joslumar/JosluFocuser/Board/Focuser-proto.brd

## EAGLE design Board/Focuser-proto.brd (2017-05-20)

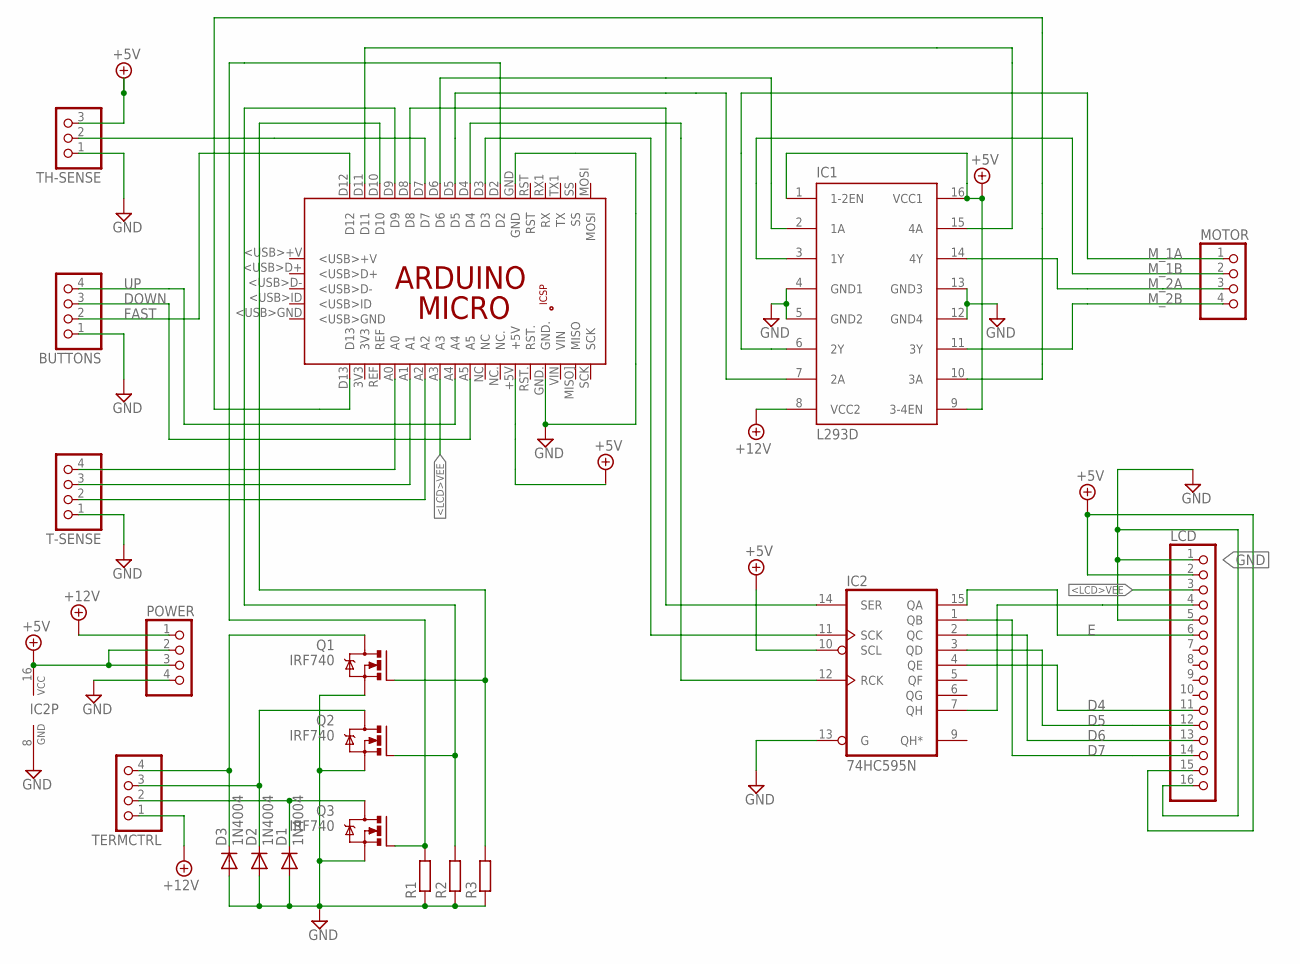
[picture p1: schematic Focuser-proto.sch]

Parts:
BUTTONS: PINHD-1X4; 1X04
D1, D2, D3: 1N4004; DO41-10
IC1: L293D; DIL16
IC2: 74HC595N; DIL16
LCD: PINHD-1X16; 1X16
MOTOR: PINHD-1X4; 1X04
PCB1: ARDUINO_MICRO
POWER: PINHD-1X4; 1X04
Q1, Q2, Q3: IRF740; TO220BV
R1, R2, R3: R-EU_0207/7; 0207/7
T-SENSE: PINHD-1X4; 1X04
TERMCTRL: PINHD-1X4; 1X04
TH-SENSE: PINHD-1X3; 1X03

Connections:
+5V: IC1.1 (1-2EN), IC1.9 (3-4EN), IC1.16 (VCC1), IC2.10 (SCL), IC2.16 (VCC), LCD.2, LCD.15, PCB1.+5V, POWER.2, POWER.3, TH-SENSE.3
+12V: IC1.8 (VCC2), POWER.1, TERMCTRL.1
<LCD>VEE: LCD.3, PCB1.A3
D4: IC2.4 (QE), LCD.11
D5: IC2.3 (QD), LCD.12
D6: IC2.2 (QC), LCD.13
D7: IC2.1 (QB), LCD.14
DOWN: BUTTONS.3, PCB1.A5
E: IC2.15 (QA), LCD.6
FAST: BUTTONS.2, PCB1.D12
GND: BUTTONS.1, D1.A, D2.A, D3.A, IC1.4 (GND1), IC1.5 (GND2), IC1.12 (GND4), IC1.13 (GND3), IC2.8 (GND), IC2.13 (G), LCD.1, LCD.5, LCD.16, PCB1.GND, PCB1.GND., POWER.4, Q1.S, Q2.S, Q3.S, R1.1, R2.1, R3.1, T-SENSE.1, TH-SENSE.1
M_1A: IC1.6 (2Y), MOTOR.1
M_1B: IC1.3 (1Y), MOTOR.2
M_2A: IC1.14 (4Y), MOTOR.3
M_2B: IC1.11 (3Y), MOTOR.4
unnamed: PCB1.A2, T-SENSE.2
unnamed: PCB1.A0, T-SENSE.4
unnamed: PCB1.A1, T-SENSE.3
unnamed: D1.C, Q3.D, TERMCTRL.2
unnamed: D2.C, Q2.D, TERMCTRL.3
unnamed: D3.C, Q1.D, TERMCTRL.4
unnamed: PCB1.D2, Q3.G, R1.2
unnamed: IC2.11 (SCK), PCB1.D3
unnamed: IC1.2 (1A), PCB1.D6
unnamed: IC1.7 (2A), PCB1.D5
unnamed: IC1.15 (4A), PCB1.D11
unnamed: IC1.10 (3A), PCB1.D13
unnamed: PCB1.D7, TH-SENSE.2
unnamed: IC2.12 (RCK), PCB1.D4
unnamed: IC2.14 (SER), PCB1.D8
unnamed: IC2.7 (QH), LCD.4
unnamed: PCB1.D9, Q2.G, R2.2
unnamed: PCB1.D10, Q1.G, R3.2
UP: BUTTONS.4, PCB1.A4

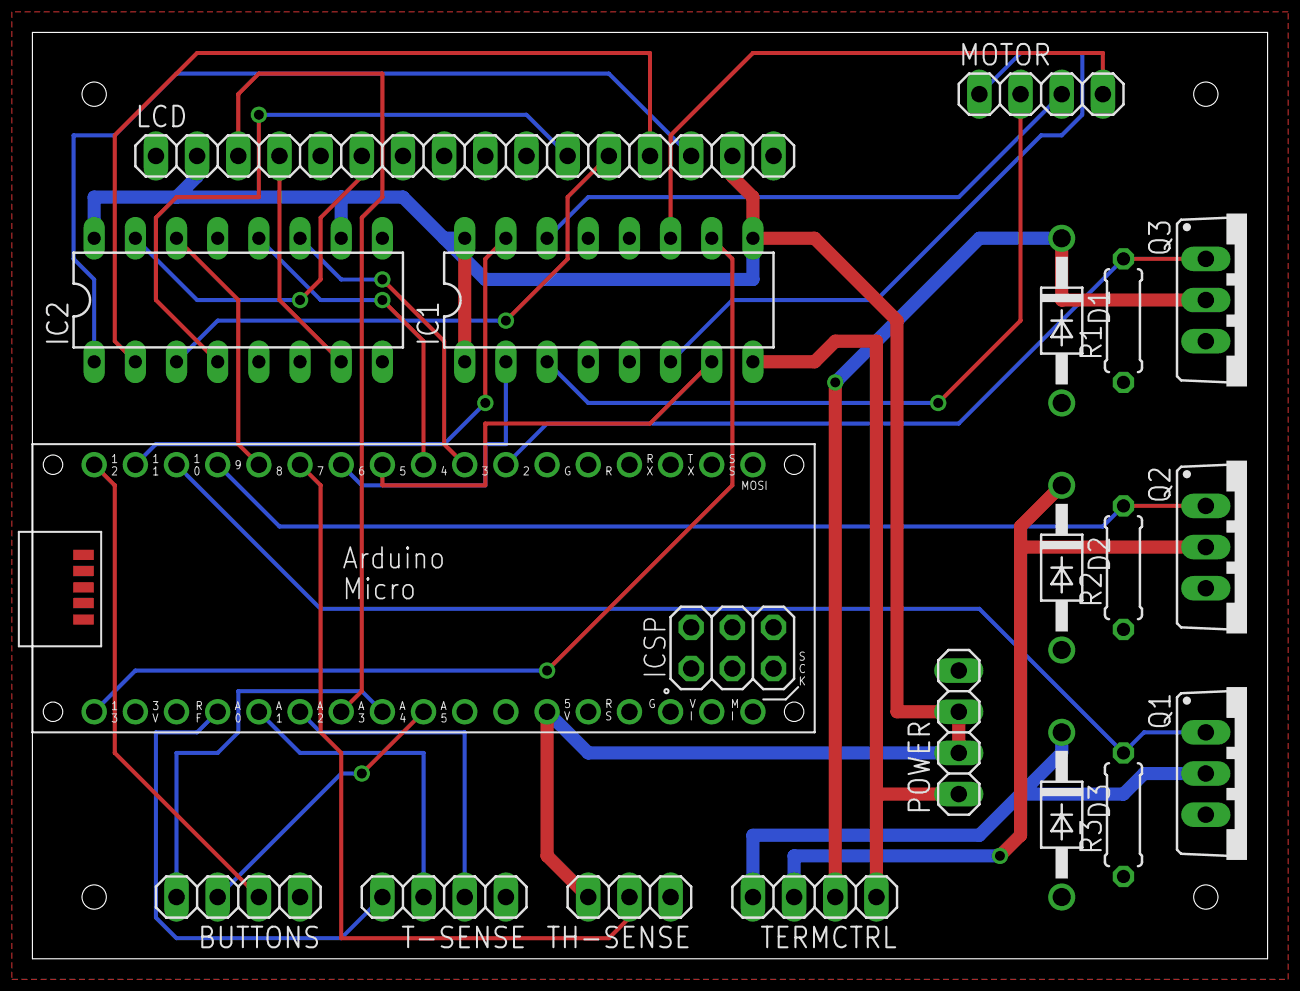
[picture p2: board Focuser-proto.brd from above]

Board: 2 copper layers, 76.2 x 57.2 mm, 19 parts (0 on the bottom side), 34 nets.
