joslumar/JosluFocuser/Board/Focuser.brd

## EAGLE design Board/Focuser.brd (2017-05-20)

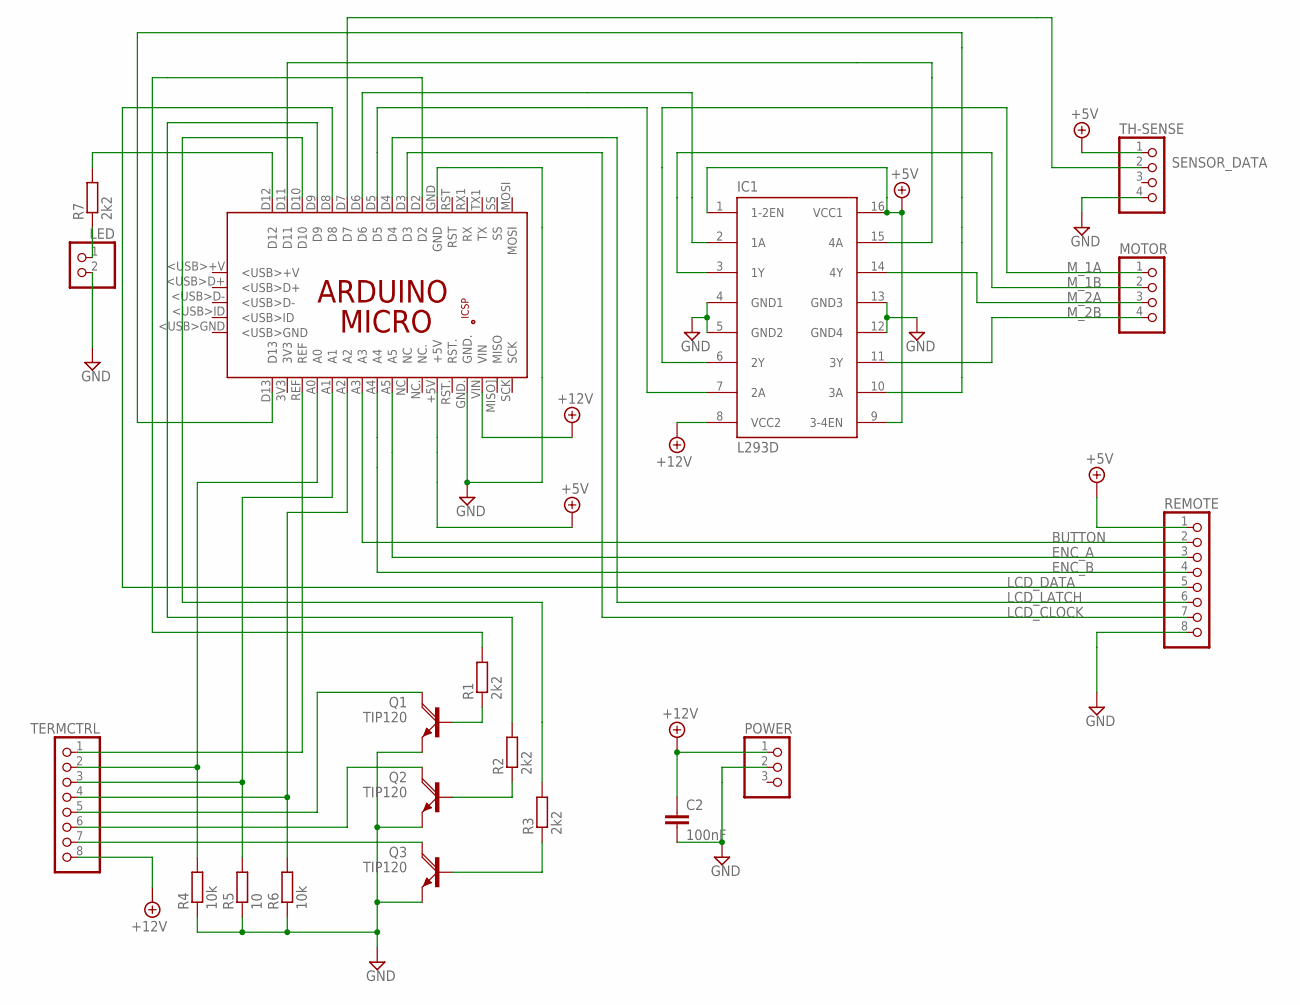
[picture p3: schematic Focuser.sch]

Parts:
C2: 100nF; C025_050-025X075
IC1: L293D; DIL16
LED: PINHD-1X2; 1X02
MOTOR: PINHD-1X4; 1X04
PCB1: ARDUINO_MICRO
POWER: PINHD-1X3; 1X03
Q1, Q2, Q3: TIP120; TO220AH
R1, R2, R3, R7: 2k2; 0207/7
R4, R6: 10k; 0207/7
R5: 10; 0207/7
REMOTE: PINHD-1X8; 1X08
TERMCTRL: PINHD-1X8; 1X08
TH-SENSE: PINHD-1X4; 1X04

Connections:
+5V: IC1.1 (1-2EN), IC1.9 (3-4EN), IC1.16 (VCC1), PCB1.+5V, REMOTE.1, TH-SENSE.1
+12V: C2.1, IC1.8 (VCC2), PCB1.VIN, POWER.1, TERMCTRL.8
BUTTON: PCB1.A3, REMOTE.2
ENC_A: PCB1.A5, REMOTE.3
ENC_B: PCB1.A4, REMOTE.4
GND: C2.2, IC1.4 (GND1), IC1.5 (GND2), IC1.12 (GND4), IC1.13 (GND3), LED.2, PCB1.GND, PCB1.GND., POWER.2, Q1.E, Q2.E, Q3.E, R4.1, R5.1, R6.1, REMOTE.8, TH-SENSE.4
LCD_CLOCK: PCB1.D3, REMOTE.7
LCD_DATA: PCB1.D8, REMOTE.5
LCD_LATCH: PCB1.D4, REMOTE.6
M_1A: IC1.6 (2Y), MOTOR.1
M_1B: IC1.3 (1Y), MOTOR.2
M_2A: IC1.14 (4Y), MOTOR.3
M_2B: IC1.11 (3Y), MOTOR.4
unnamed: PCB1.A2, R6.2, TERMCTRL.4
unnamed: PCB1.A0, R4.2, TERMCTRL.2
unnamed: PCB1.A1, R5.2, TERMCTRL.3
unnamed: Q3.C, TERMCTRL.7
unnamed: Q2.C, TERMCTRL.6
unnamed: Q1.C, TERMCTRL.5
unnamed: PCB1.D2, R1.2
unnamed: IC1.2 (1A), PCB1.D6
unnamed: IC1.7 (2A), PCB1.D5
unnamed: IC1.15 (4A), PCB1.D11
unnamed: LED.1, R7.1
unnamed: IC1.10 (3A), PCB1.D13
unnamed: PCB1.D12, R7.2
unnamed: Q3.B, R3.1
unnamed: Q2.B, R2.1
unnamed: Q1.B, R1.1
unnamed: PCB1.D9, R2.2
unnamed: PCB1.D10, R3.2
unnamed: PCB1.REF, TERMCTRL.1
SENSOR_DATA: PCB1.D7, TH-SENSE.2

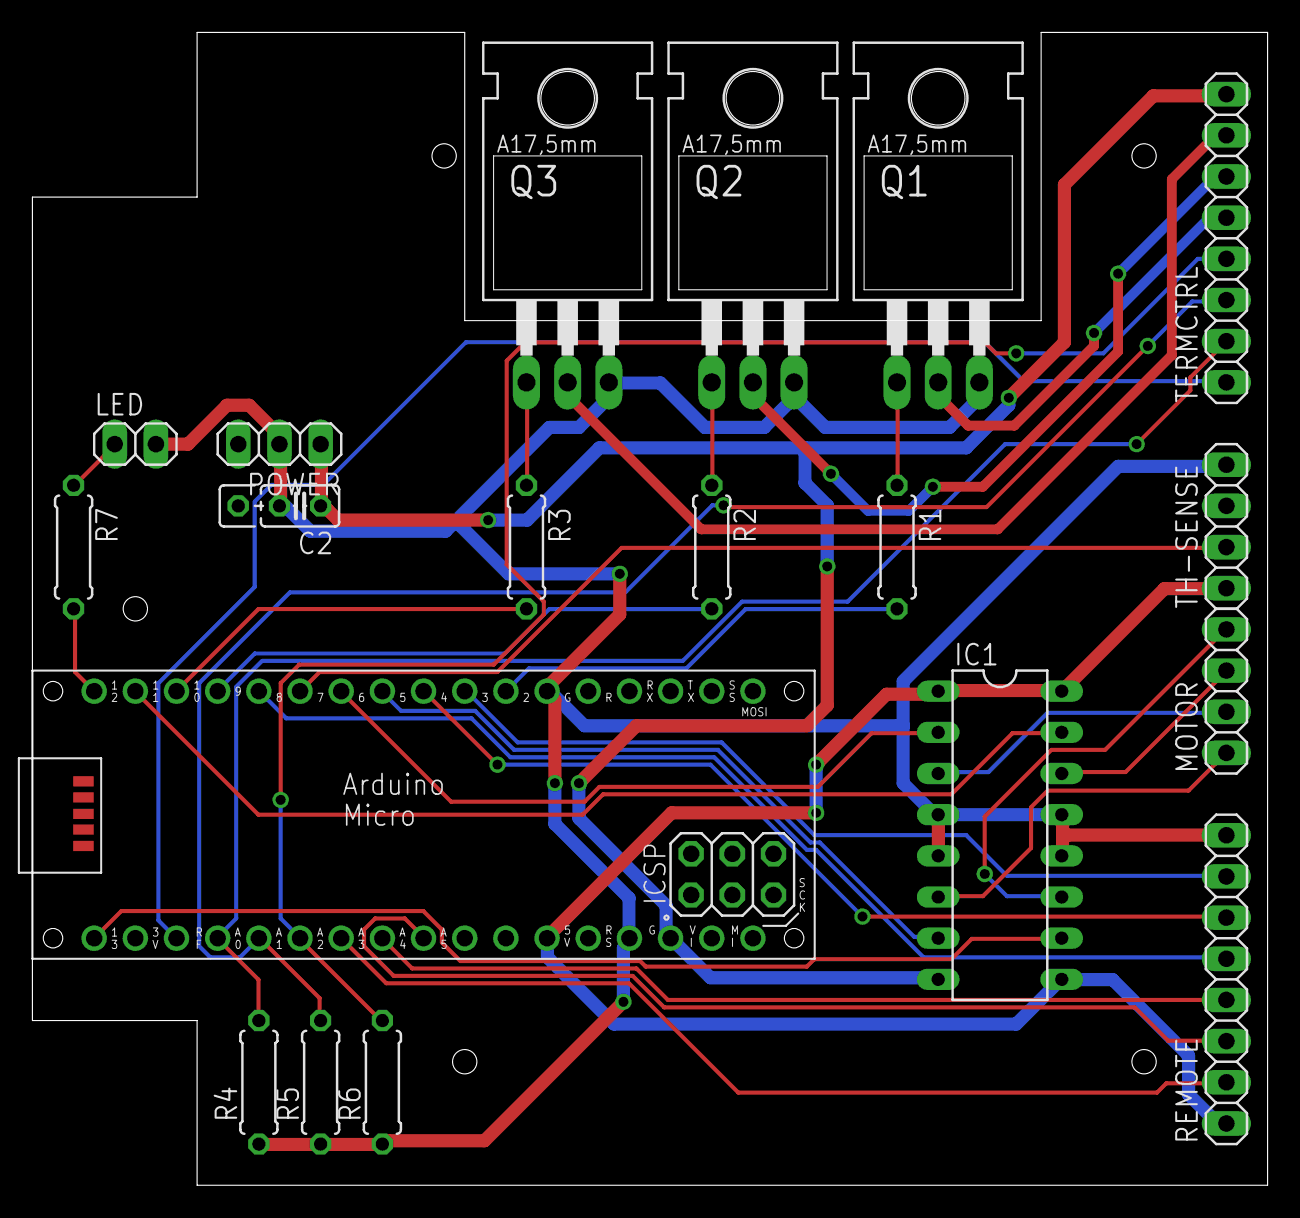
[picture p4: board Focuser.brd from above]

Board: 2 copper layers, 76.2 x 71.1 mm, 19 parts (0 on the bottom side), 33 nets.
