joslumar/JosluFocuser/(commit log)

2017-05-20 new file: Board/Focuser-proto.brd new file: Board/Focuser-proto.sch new file: Board/Focuser.brd new file: Board/Focuser.sch
    [Focuser-base.brd, Focuser-proto.brd, Focuser-proto.sch, Focuser.brd, Focuser.sch]
2017-05-20 renamed: Focuser.h -> JosluFocuser/JosluFocuser.h renamed: Focuser_v13.ino -> JosluFocuser/JosluFocuser.ino deleted: Board/Focuser-base.brd
2017-05-20 new file: indi/CMakeLists.txt new file: indi/cmake_modules/FindINDI.cmake new file: indi/config.h.cmake new file: indi/joslufocus.cpp new file: indi/joslufocus.h new file: indi/joslufocus.xml.cmake d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
2017-05-20 deleted: Board/Focuser-base.brd
    [Focuser-base.brd]
